alinicia/SolderSync/README.md

# SolderSync PCB Design
Modification of the T-962 reflow owen, ESP32 core with TFT LCD &amp; Custom Profiles
