alinicia/SolderSync/v2.1.0/Schematics/Main/Main_BOOT&EN.png

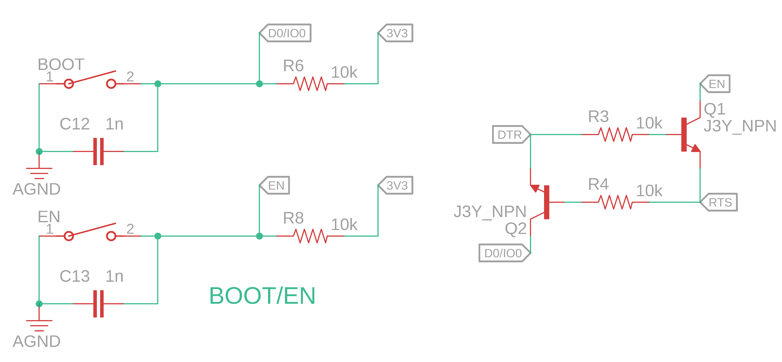
v2.1.0/Schematics/Main/Main_BOOT&EN.png
