alinicia/SolderSync/v2.1.0/Schematics/Main/Main_Connectors.png

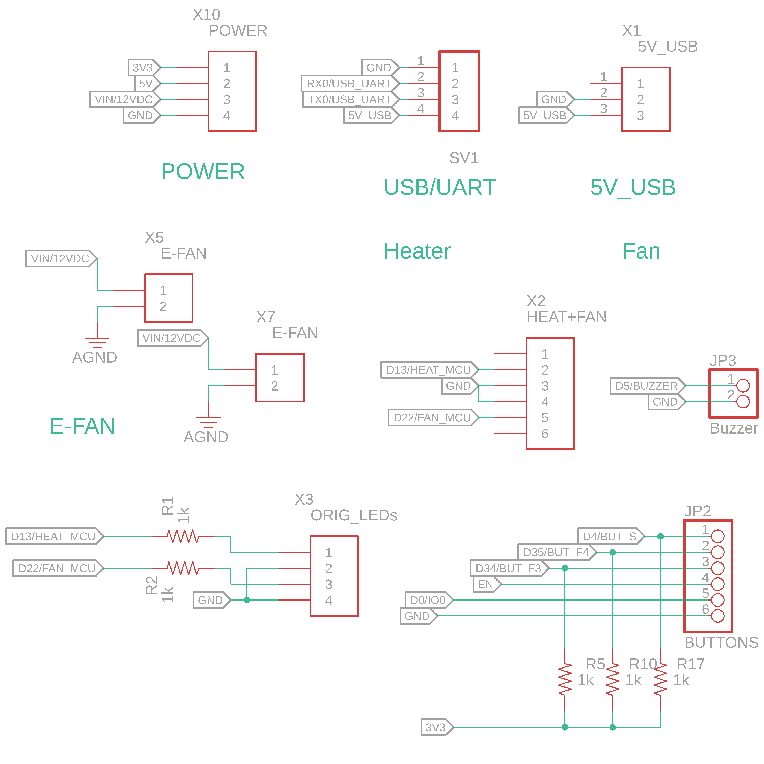
v2.1.0/Schematics/Main/Main_Connectors.png
