alinicia/SolderSync/v2.1.0/Schematics/Main/Main_LCD.png

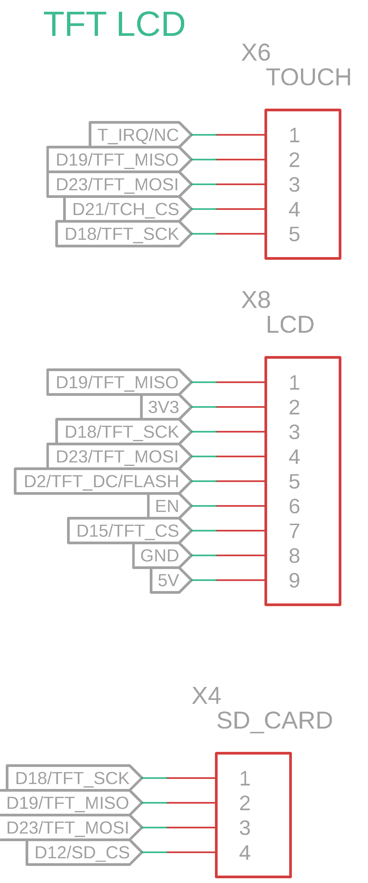
v2.1.0/Schematics/Main/Main_LCD.png
