alinicia/SolderSync/v2.1.0/Schematics/Main/Main_LEDs.png

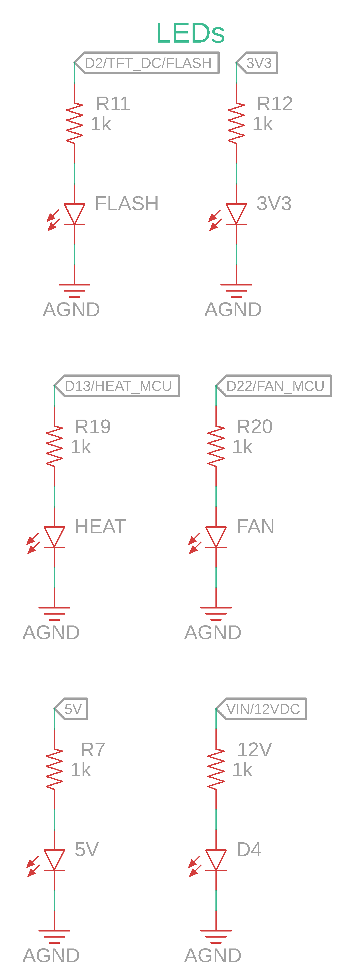
v2.1.0/Schematics/Main/Main_LEDs.png
