alinicia/SolderSync/v2.1.0/Schematics/Main/Main_MCU.png

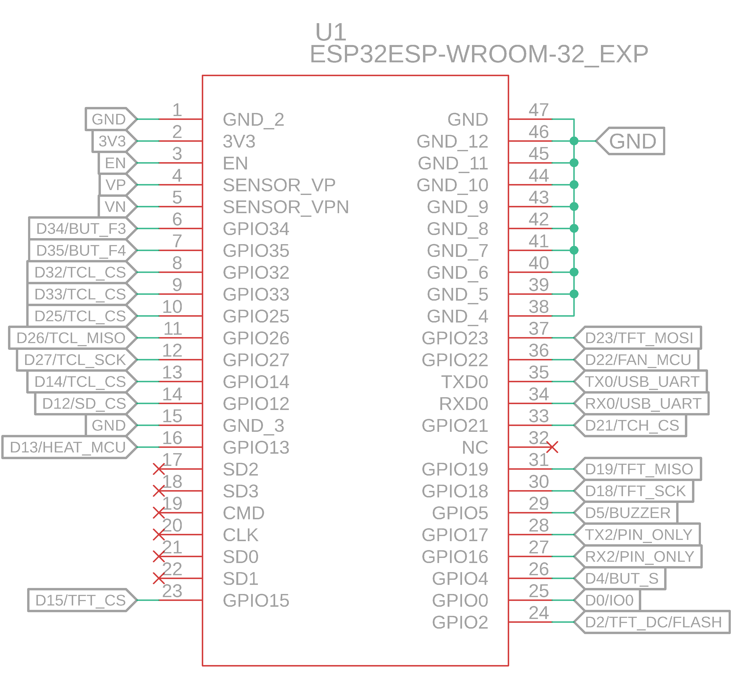
v2.1.0/Schematics/Main/Main_MCU.png
