alinicia/SolderSync/v2.1.0/Schematics/Main/Main_Thermocouples.png

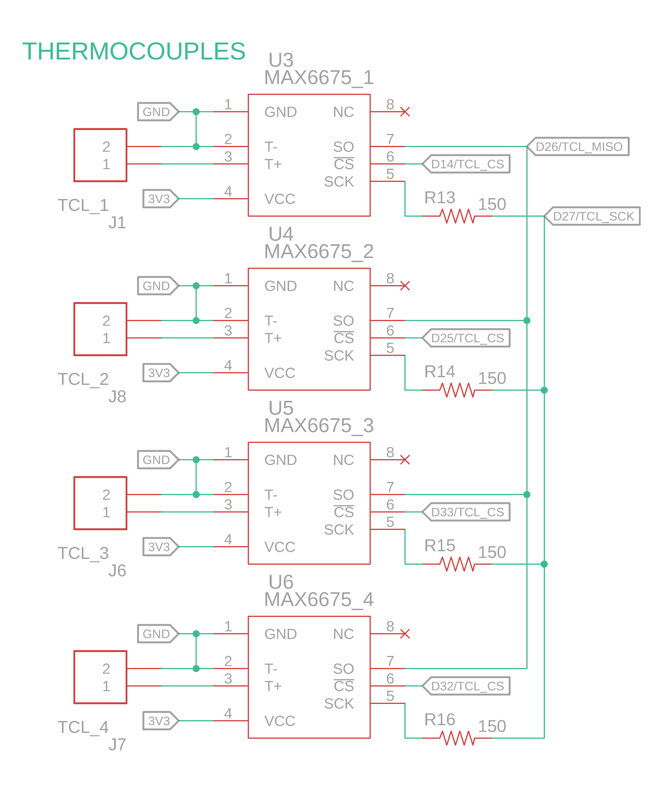
v2.1.0/Schematics/Main/Main_Thermocouples.png
