alinicia/SolderSync/v2.1.0/Schematics/Power/Power_ACDC.png

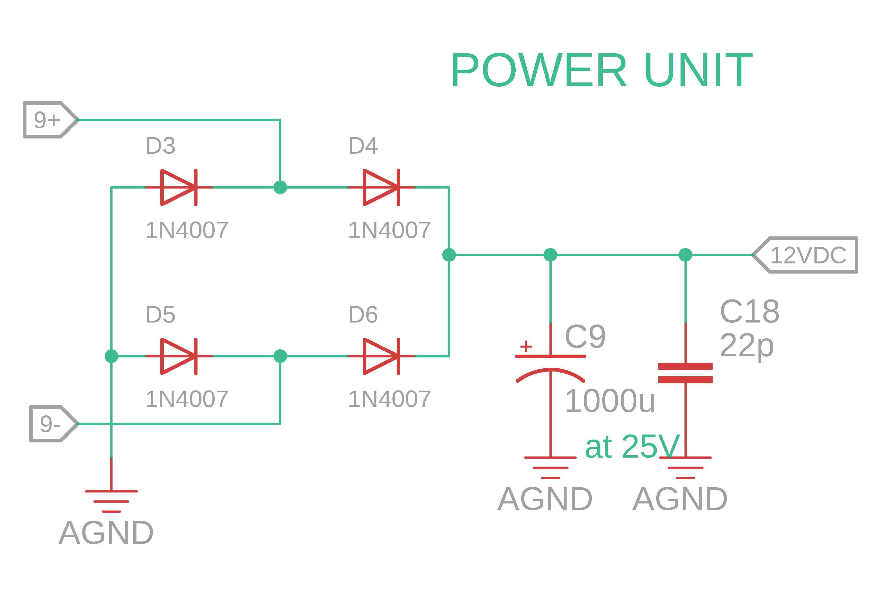
v2.1.0/Schematics/Power/Power_ACDC.png
