alinicia/SolderSync/v2.1.0/Schematics/Power/Power_LEDs&Connectors.png

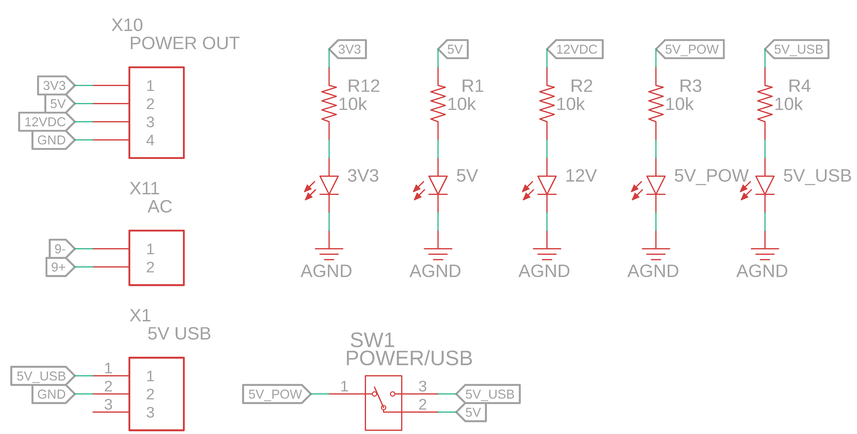
v2.1.0/Schematics/Power/Power_LEDs&Connectors.png
