alinicia/SolderSync/v2.1.0/Schematics/Power/Power_Regulators.png

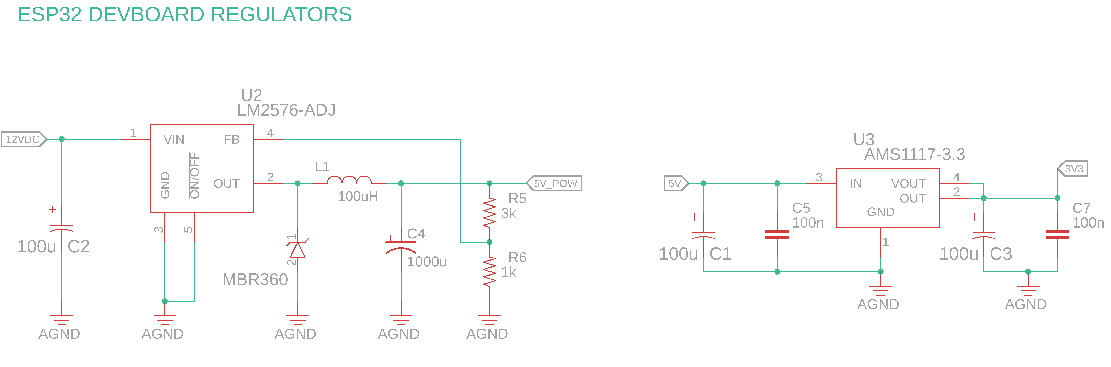
v2.1.0/Schematics/Power/Power_Regulators.png
