alinicia/SolderSync/v2.1.0/v1 USB_UART.brd

## EAGLE design v2.1.0/v1 USB_UART.brd (2025-04-17, an earlier design)

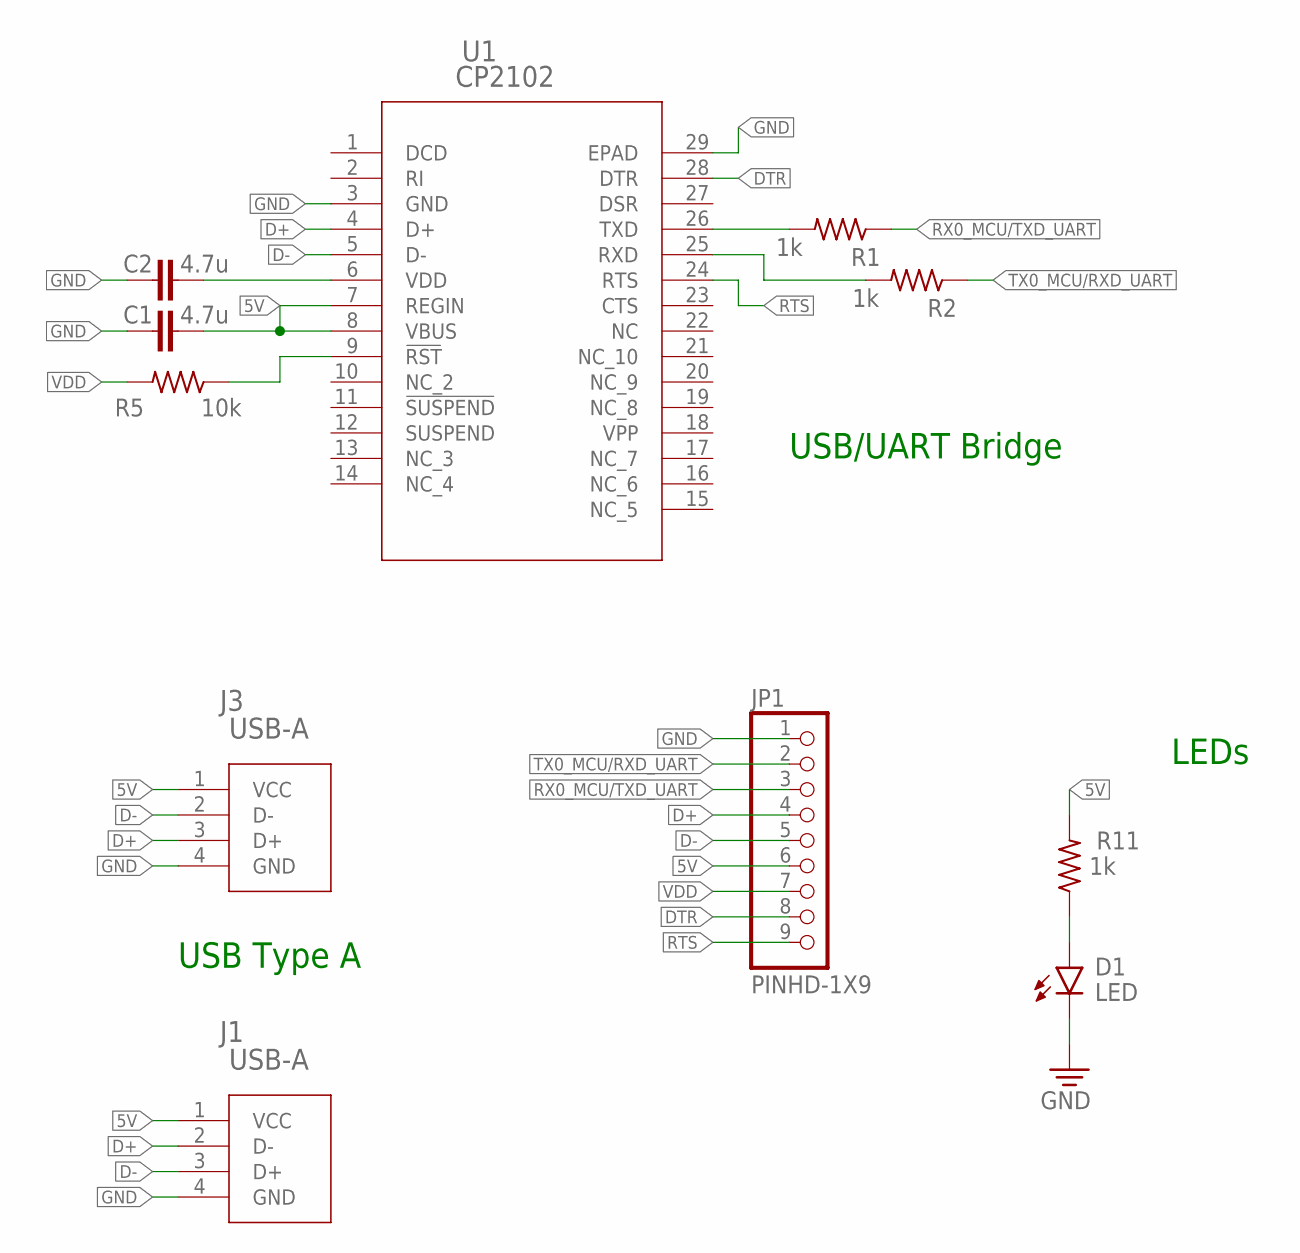
[picture p12: schematic v1 USB_UART.sch]

Parts:
C1, C2: 4.7u; CAPC2012X110
D1: LED; LEDC2012X110N_FLAT-B
J1, J3: USB-A
JP1: PINHD-1X9; 1X09
R1, R2, R11: 1k; RESC2012X65
R5: 10k; RESC2012X65
U1: CP2102; QFN28_5X5_SIL

Connections:
5V: C1.2, J1.1 (VCC), J3.1 (VCC), JP1.6, R11.2, U1.7 (REGIN), U1.8 (VBUS)
D+: J1.2 (D-), J3.3 (D+), JP1.4, U1.4 (D+)
D-: J1.3 (D+), J3.2 (D-), JP1.5, U1.5 (D-)
DTR: JP1.8, U1.28 (DTR)
GND: C1.1, C2.1, D1.C, J1.4 (GND), J3.4 (GND), JP1.1, U1.3 (GND), U1.29 (EPAD)
unnamed: D1.A, R11.1
unnamed: R5.1, U1.9 (!RST)
RTS: JP1.9, U1.24 (RTS)
RX0_MCU/TXD_UART: JP1.3, R1.1
RXD: R2.2, U1.25 (RXD)
TX0_MCU/RXD_UART: JP1.2, R2.1
TXD: R1.2, U1.26 (TXD)
VDD: C2.2, JP1.7, R5.2, U1.6 (VDD)

Notes on the sheet:
USB/UART Bridge
USB Type A
LEDs

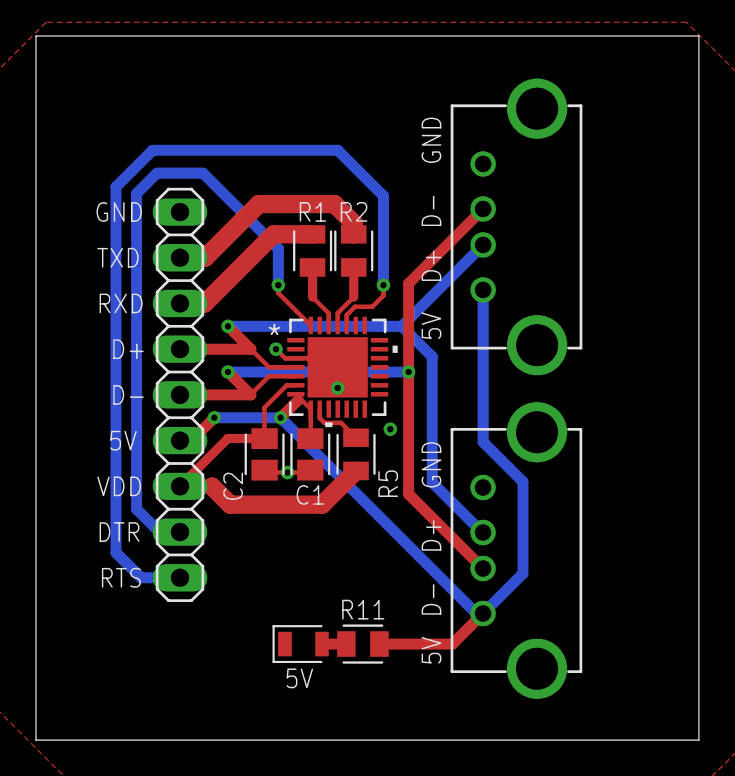
[picture p13: board v1 USB_UART.brd from above]

Board: 2 copper layers, 36.8 x 39.1 mm, 11 parts (0 on the bottom side), 13 nets.
