alinicia/SolderSync/v2.1.0/v2.1 Power.brd

## EAGLE design v2.1.0/v2.1 Power.brd (2025-04-17)

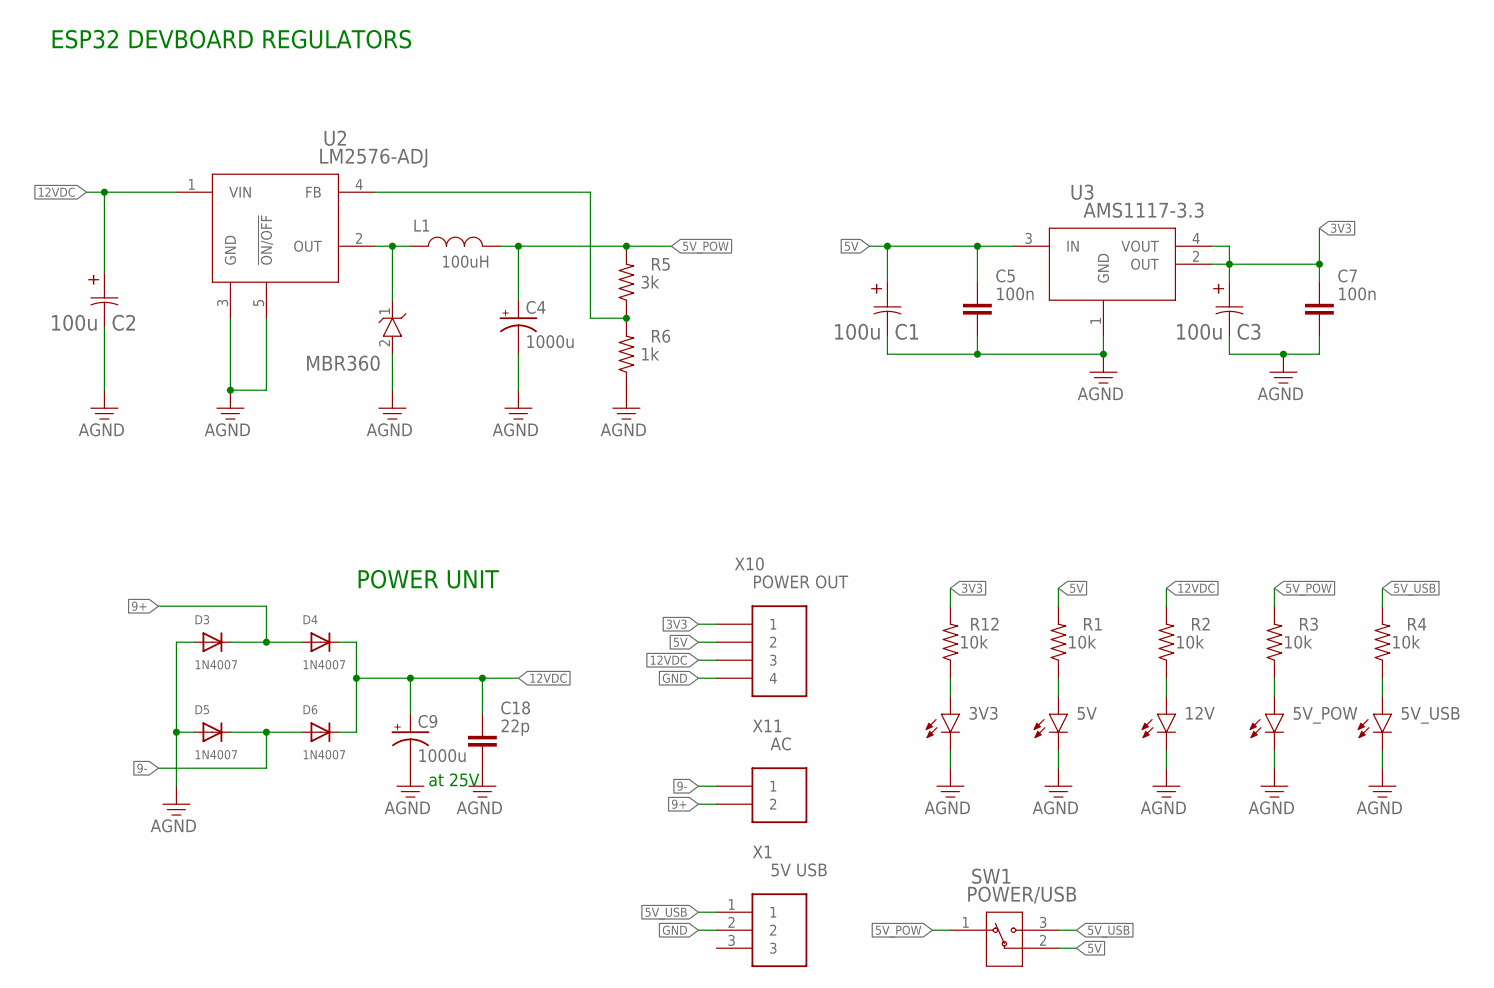
[picture p14: schematic v2.1 Power.sch]

Parts:
3V3, 5V, 5V_POW, 5V_USB, 12V: LED; LEDC2012X110N_FLAT-B
C1, C2, C3: 100u; 100UF_CAP
C4, C9: 1000u; CAP_10X20IN
C5, C7: 100n; CAPC2012X110
C18: 22p; CAPC2012X110
D3, D4, D5, D6: 1N4007; SOD-123FL
L1: 100uH; IND_MURATA_2200_MUR
MBR360: MBR360RLGDO-201AD_ONS; DO-201AD_ONS
R1, R2, R3, R4, R12: 10k; RESC2012X65
R5: 3k; RESC2012X65
R6: 1k; RESC2012X65
SW1: POWER/USB; SS-12D10G5_XKB
U2: LM2576-ADJ; T05A_TEX
U3: AMS1117-3.3; _ADS-L
X1: 5V USB; JST-XH-03-PACKAGE-LONG-PAD
X10: POWER OUT; JST-XH-04-PACKAGE-LONG-PAD
X11: AC; -LONG-PAD

Connections:
3V3: C3.1, C7.1, R12.2, U3.2 (OUT), U3.4 (VOUT), X10.1
5V: C1.1, C5.1, R1.2, SW1.2, U3.3 (IN), X10.2
5V_POW: C4.1 (+), L1.1, R3.2, R5.2, SW1.1
5V_USB: R4.2, SW1.3, X1.1
9+: D3.C, D4.A, X11.2
9-: D5.C, D6.A, X11.1
12VDC: C2.1, C9.1 (+), C18.1, D4.C, D6.C, R2.2, U2.1 (VIN), X10.3
FB: R5.1, R6.2, U2.4 (FB)
GND: 3V3.C, 5V.C, 5V_POW.C, 5V_USB.C, 12V.C, C1.2, C2.2, C3.2, C4.2 (-), C5.2, C7.2, C9.2 (-), C18.2, D3.A, D5.A, MBR360.2 (ANODE), R6.1, U2.3 (GND), U2.5 (!ON/OFF), U3.1 (GND), X1.2, X10.4
unnamed: 5V.A, R1.1
unnamed: L1.2, MBR360.1 (CATHODE), U2.2 (OUT)
unnamed: 12V.A, R2.1
unnamed: 5V_POW.A, R3.1
unnamed: 5V_USB.A, R4.1
unnamed: 3V3.A, R12.1

Notes on the sheet:
ESP32 DEVBOARD REGULATORS
POWER UNIT
at 25V

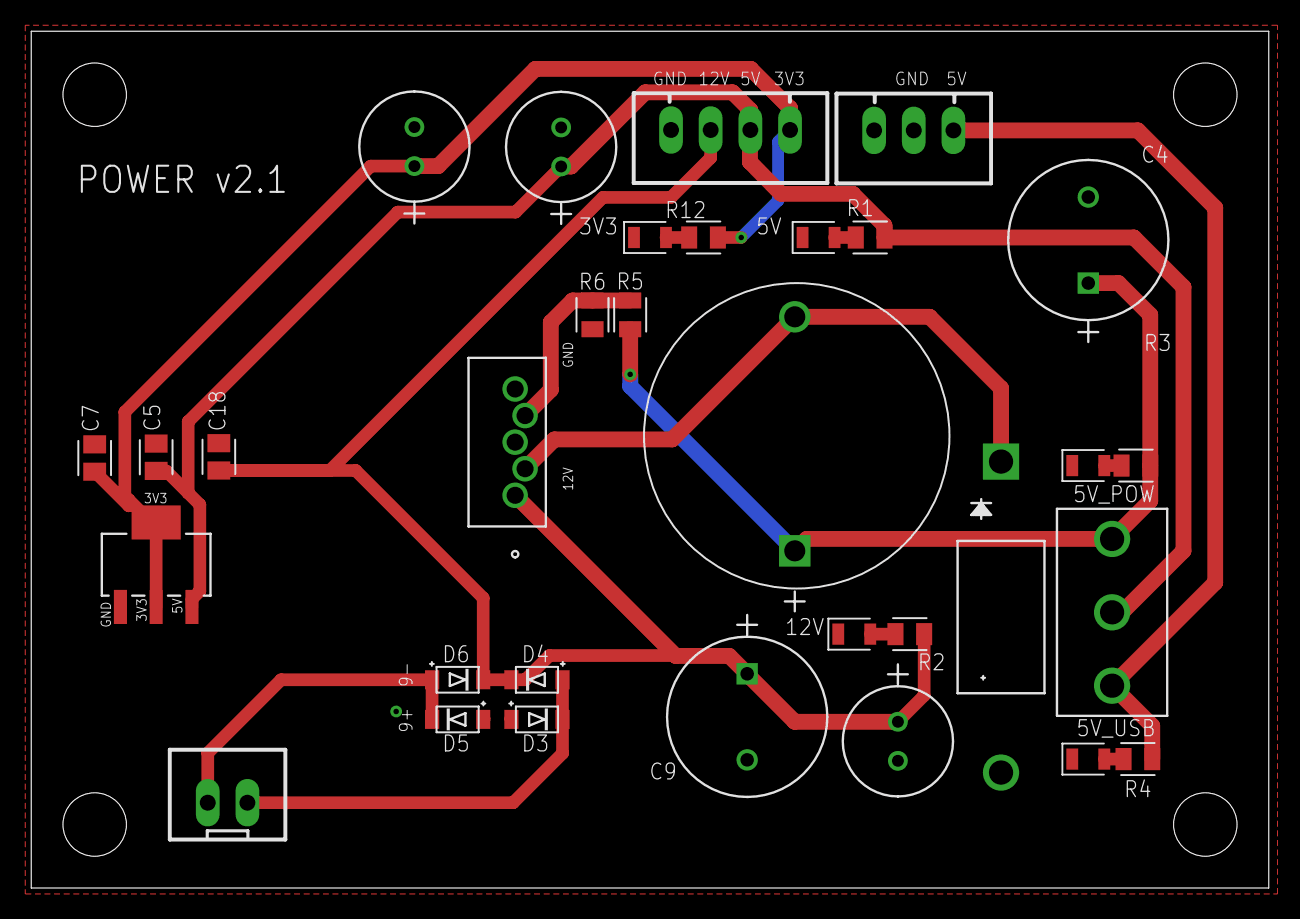
[picture p15: board v2.1 Power.brd from above]

Board: 2 copper layers, 79.2 x 54.9 mm, 32 parts (0 on the bottom side), 15 nets.
