alinicia/SolderSync/v2.1.0/v2.1 Main.brd

## EAGLE design v2.1.0/v2.1 Main.brd (2025-04-17)

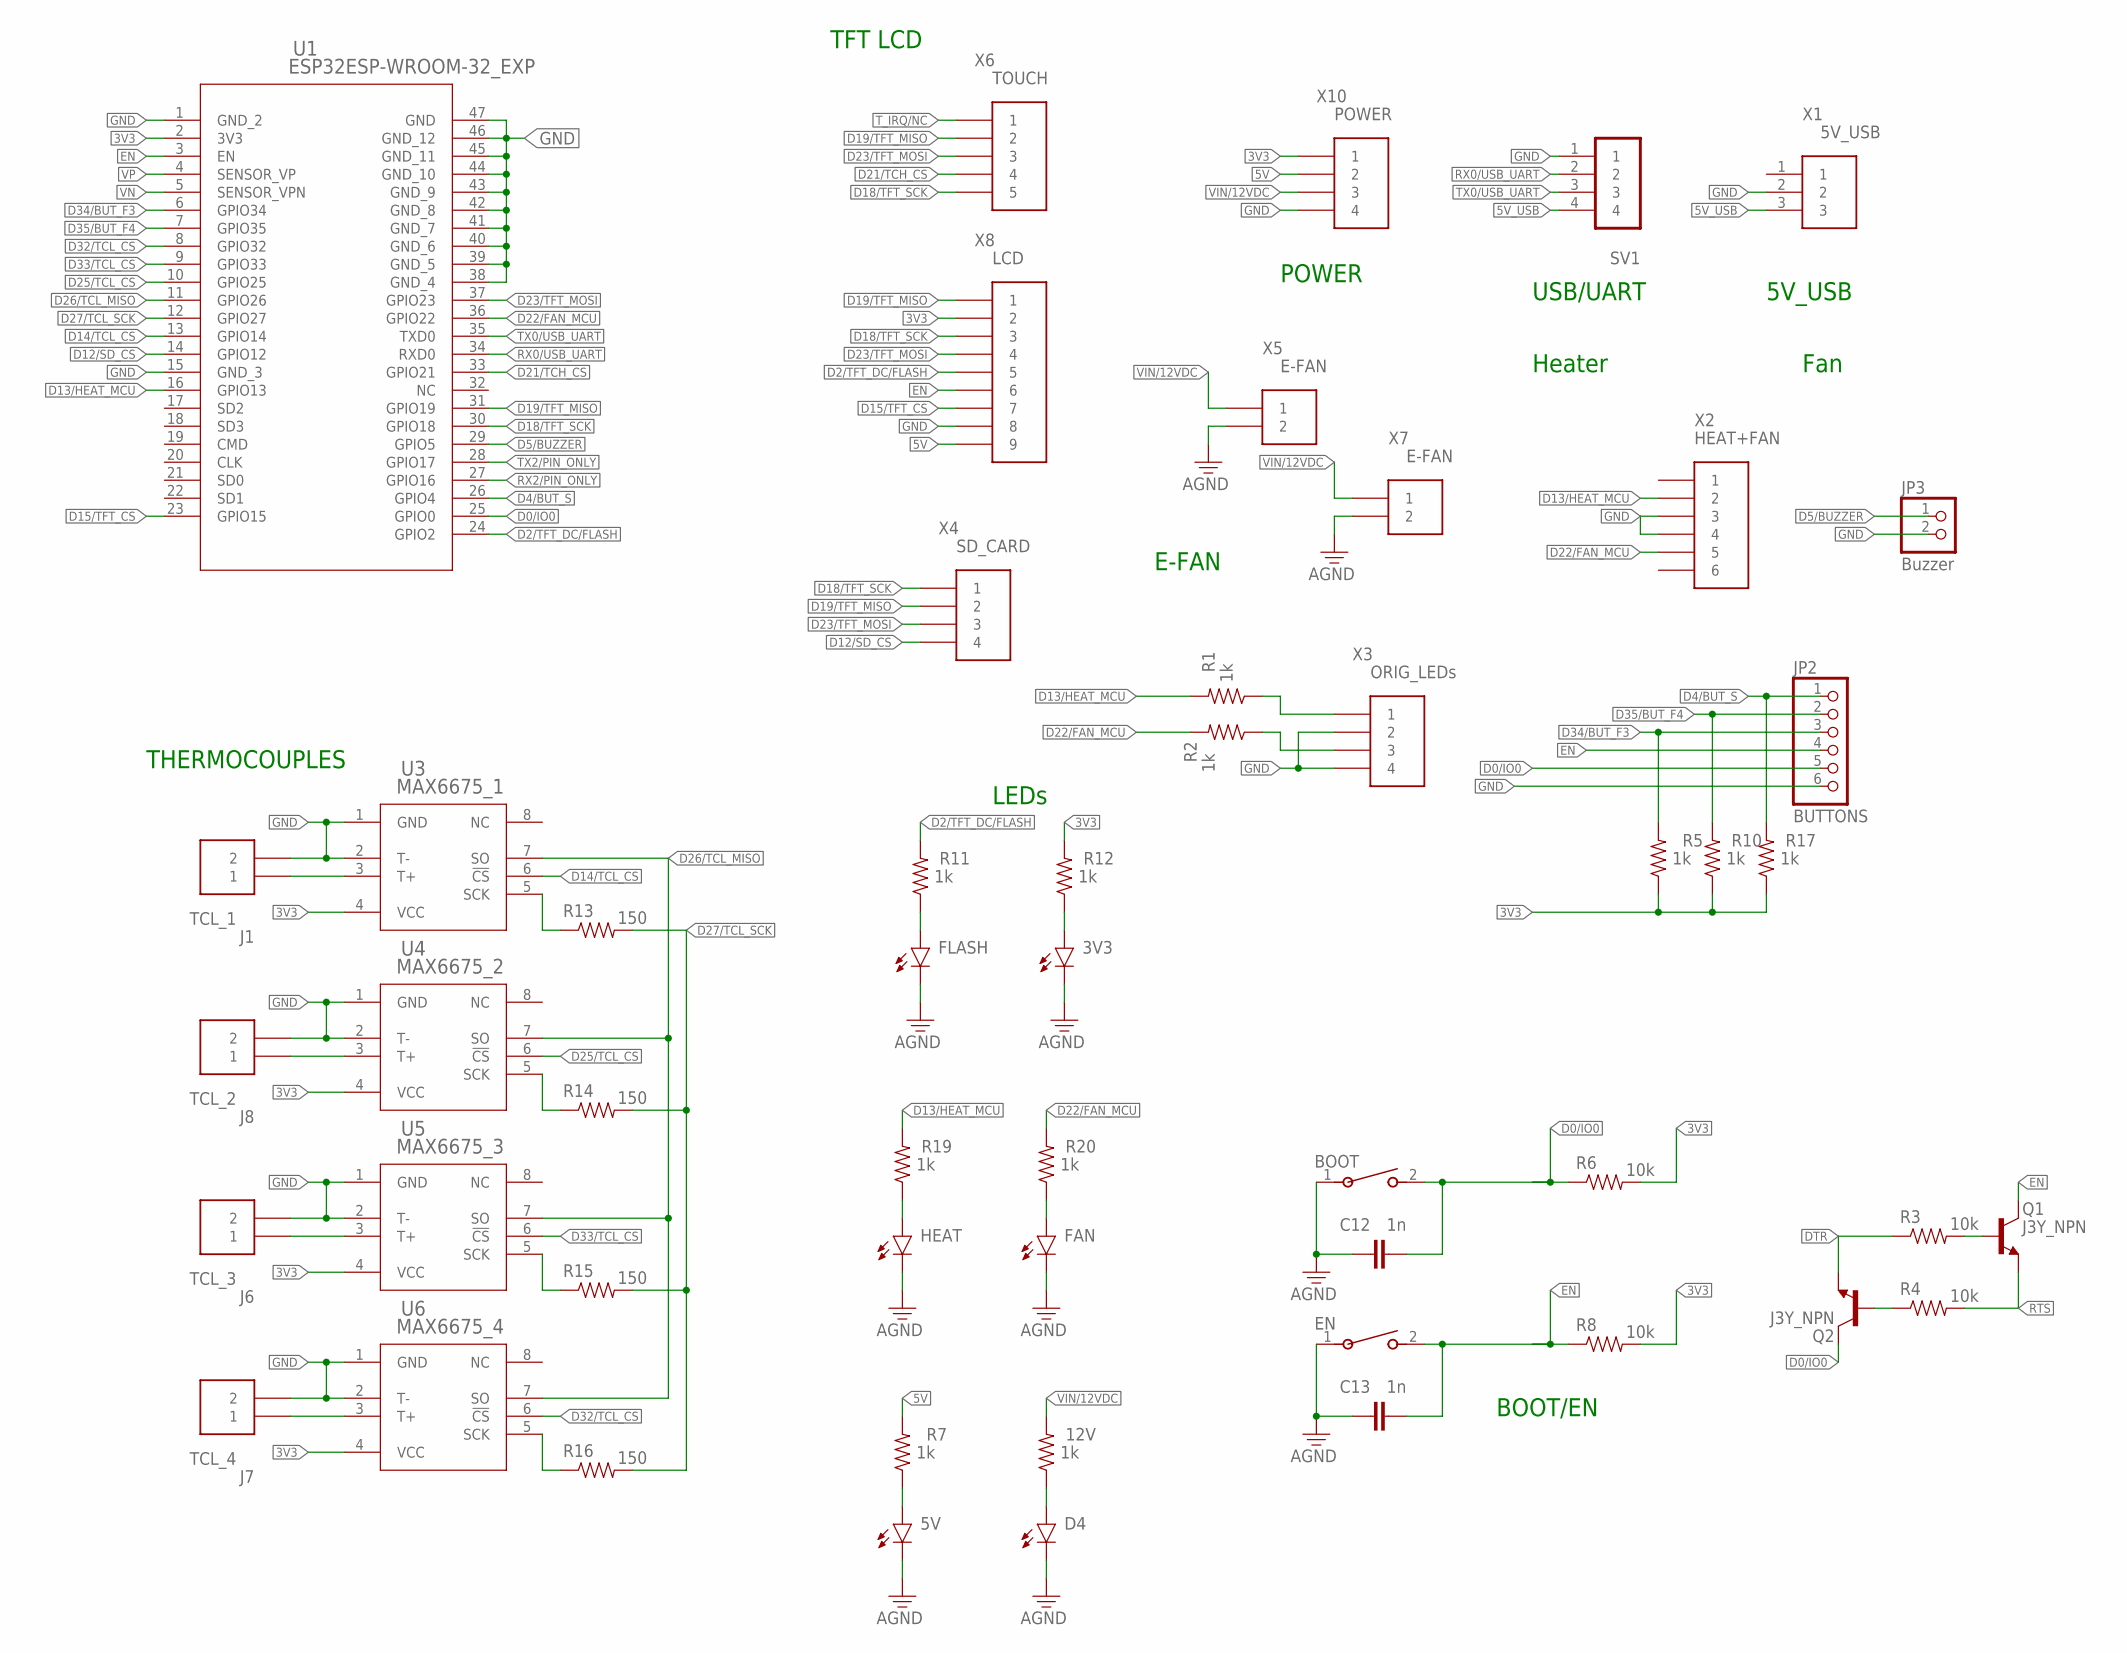
[picture p16: schematic v2.1 Main.sch]

Parts:
3V3, 5V: LED; LEDC2012X110N_FLAT-B
12V: 1k; RESC2012X65
BOOT: EVQ22705RSW_EVQ22705R_PAN; SW_EVQ22705R_PAN
C12, C13: 1n; CAPC2012X110
D4: LED; LEDC2012X110N_FLAT-B
EN: EVQ22705RSW_EVQ22705R_PAN; SW_EVQ22705R_PAN
FAN: LED; LEDC2012X110N_FLAT-B
FLASH: LED; LEDC2012X110N_FLAT-B
HEAT: LED; LEDC2012X110N_FLAT-B
J1: TCL_1; CONN_OSTVN02A150_OST
J6: TCL_3; CONN_OSTVN02A150_OST
J7: TCL_4; CONN_OSTVN02A150_OST
J8: TCL_2; CONN_OSTVN02A150_OST
JP2: BUTTONS; 1X06
JP3: Buzzer; 1X02
Q1, Q2: J3Y_NPN; SC59
R1, R2, R5, R7, R10, R11, R12, R17, R19, R20: 1k; RESC2012X65
R3, R4, R6, R8: 10k; RESC2012X65
R13, R14, R15, R16: 150; RESC2012X65
SV1: FEM-HEAD; FE05-1
U1: ESP32ESP-WROOM-32_EXP; ESP32_SCH_PCB
U3: MAX6675_1; 21-0041B_8_MXM
U4: MAX6675_2; 21-0041B_8_MXM
U5: MAX6675_3; 21-0041B_8_MXM
U6: MAX6675_4; 21-0041B_8_MXM
X1: 5V_USB; JST-XH-03-PACKAGE-LONG-PAD
X2: HEAT+FAN; JST-XH-06-PACKAGE-LONG-PAD
X3: ORIG_LEDs; JST-XH-04-PACKAGE-LONG-PAD
X4: SD_CARD; JST-XH-04-PACKAGE-LONG-PAD
X5, X7: E-FAN; -LONG-PAD
X6: TOUCH; JST-XH-05-PACKAGE-LONG-PAD
X8: LCD; JST-XH-09-PACKAGE-LONG-PAD
X10: POWER; JST-XH-04-PACKAGE-LONG-PAD

Connections:
3V3: R5.1, R6.2, R8.2, R10.1, R12.2, R17.1, U1.2 (3V3), U3.4 (VCC), U4.4 (VCC), U5.4 (VCC), U6.4 (VCC), X8.2, X10.1
5V: R7.2, X8.9, X10.2
5V_USB: SV1.4, X1.3
D0/IO0: BOOT.2, C12.2, JP2.5, Q2.C, R6.1, U1.25 (GPIO0)
D2/TFT_DC/FLASH: R11.2, U1.24 (GPIO2), X8.5
D4/BUT_S: JP2.1, R17.2, U1.26 (GPIO4)
D5/BUZZER: JP3.1, U1.29 (GPIO5)
D12/SD_CS: U1.14 (GPIO12), X4.4
D13/HEAT_MCU: R1.2, R19.2, U1.16 (GPIO13), X2.2
D14/TCL_CS: U1.13 (GPIO14), U3.6 (!CS)
D15/TFT_CS: U1.23 (GPIO15), X8.7
D18/TFT_SCK: U1.30 (GPIO18), X4.1, X6.5, X8.3
D19/TFT_MISO: U1.31 (GPIO19), X4.2, X6.2, X8.1
D21/TCH_CS: U1.33 (GPIO21), X6.4
D22/FAN_MCU: R2.2, R20.2, U1.36 (GPIO22), X2.5
D23/TFT_MOSI: U1.37 (GPIO23), X4.3, X6.3, X8.4
D25/TCL_CS: U1.10 (GPIO25), U4.6 (!CS)
D26/TCL_MISO: U1.11 (GPIO26), U3.7 (SO), U4.7 (SO), U5.7 (SO), U6.7 (SO)
D27/TCL_SCK: R13.2, R14.2, R15.2, R16.2, U1.12 (GPIO27)
D32/TCL_CS: U1.8 (GPIO32), U6.6 (!CS)
D33/TCL_CS: U1.9 (GPIO33), U5.6 (!CS)
D34/BUT_F3: JP2.3, R5.2, U1.6 (GPIO34)
D35/BUT_F4: JP2.2, R10.2, U1.7 (GPIO35)
DTR: Q2.E, R3.1
EN: C13.2, EN.2, JP2.4, Q1.C, R8.1, U1.3 (EN), X8.6
FAN_LED: R2.1, X3.3
GND: 3V3.C, 5V.C, BOOT.1, C12.1, C13.1, D4.C, EN.1, FAN.C, FLASH.C, HEAT.C, J1.2, J6.2, J7.2, J8.2, JP2.6, JP3.2, SV1.1, U1.1 (GND_2), U1.15 (GND_3), U1.38 (GND_4), U1.39 (GND_5), U1.40 (GND_6), U1.41 (GND_7), U1.42 (GND_8), U1.43 (GND_9), U1.44 (GND_10), U1.45 (GND_11), U1.46 (GND_12), U1.47 (GND), U3.1 (GND), U3.2 (T-), U4.1 (GND), U4.2 (T-), U5.1 (GND), U5.2 (T-), U6.1 (GND), U6.2 (T-), X1.2, X2.3, X2.4, X3.2, X3.4, X5.2, X7.2, X8.8, X10.4
HEAT_LED: R1.1, X3.1
unnamed: FLASH.A, R11.1
unnamed: Q1.B, R3.2
unnamed: Q2.B, R4.1
unnamed: 3V3.A, R12.1
unnamed: 5V.A, R7.1
unnamed: 12V.1, D4.A
unnamed: HEAT.A, R19.1
unnamed: FAN.A, R20.1
RTS: Q1.E, R4.2
RX0/USB_UART: SV1.2, U1.34 (RXD0)
RX2/PIN_ONLY: U1.27 (GPIO16)
T1: J1.1, U3.3 (T+)
T2: J8.1, U4.3 (T+)
T3: J6.1, U5.3 (T+)
T4: J7.1, U6.3 (T+)
TCL_SCK1: R13.1, U3.5 (SCK)
TCL_SCK2: R14.1, U4.5 (SCK)
TCL_SCK3: R15.1, U5.5 (SCK)
TCL_SCK4: R16.1, U6.5 (SCK)
TX0/USB_UART: SV1.3, U1.35 (TXD0)
TX2/PIN_ONLY: U1.28 (GPIO17)
T_IRQ/NC: X6.1
VIN/12VDC: 12V.2, X5.1, X7.1, X10.3
VN: U1.5 (SENSOR_VPN)
VP: U1.4 (SENSOR_VP)

Notes on the sheet:
TFT LCD
BOOT/EN
LEDs
THERMOCOUPLES
E-FAN
POWER
Heater
Fan
USB/UART
5V_USB

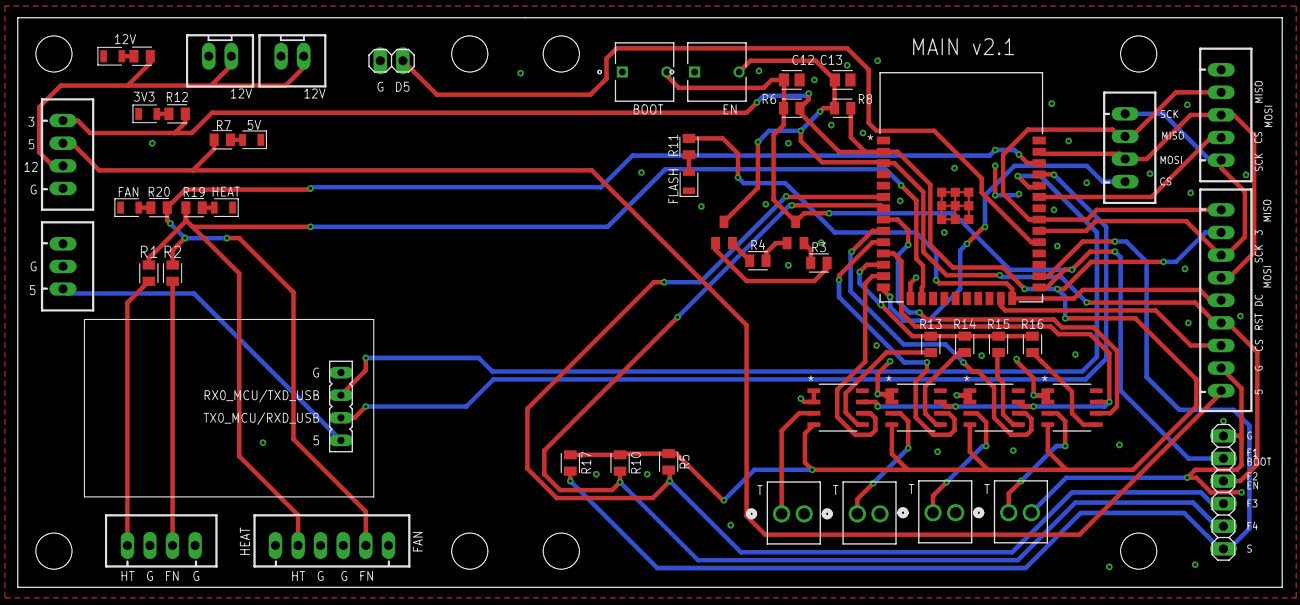
[picture p17: board v2.1 Main.brd from above]

Board: 2 copper layers, 142.1 x 64.0 mm, 52 parts (0 on the bottom side), 48 nets.
