alinicia/SolderSync/v1.1.0/v1.1 Main.brd

## EAGLE design v1.1.0/v1.1 Main.brd (2025-03-05, an earlier design)

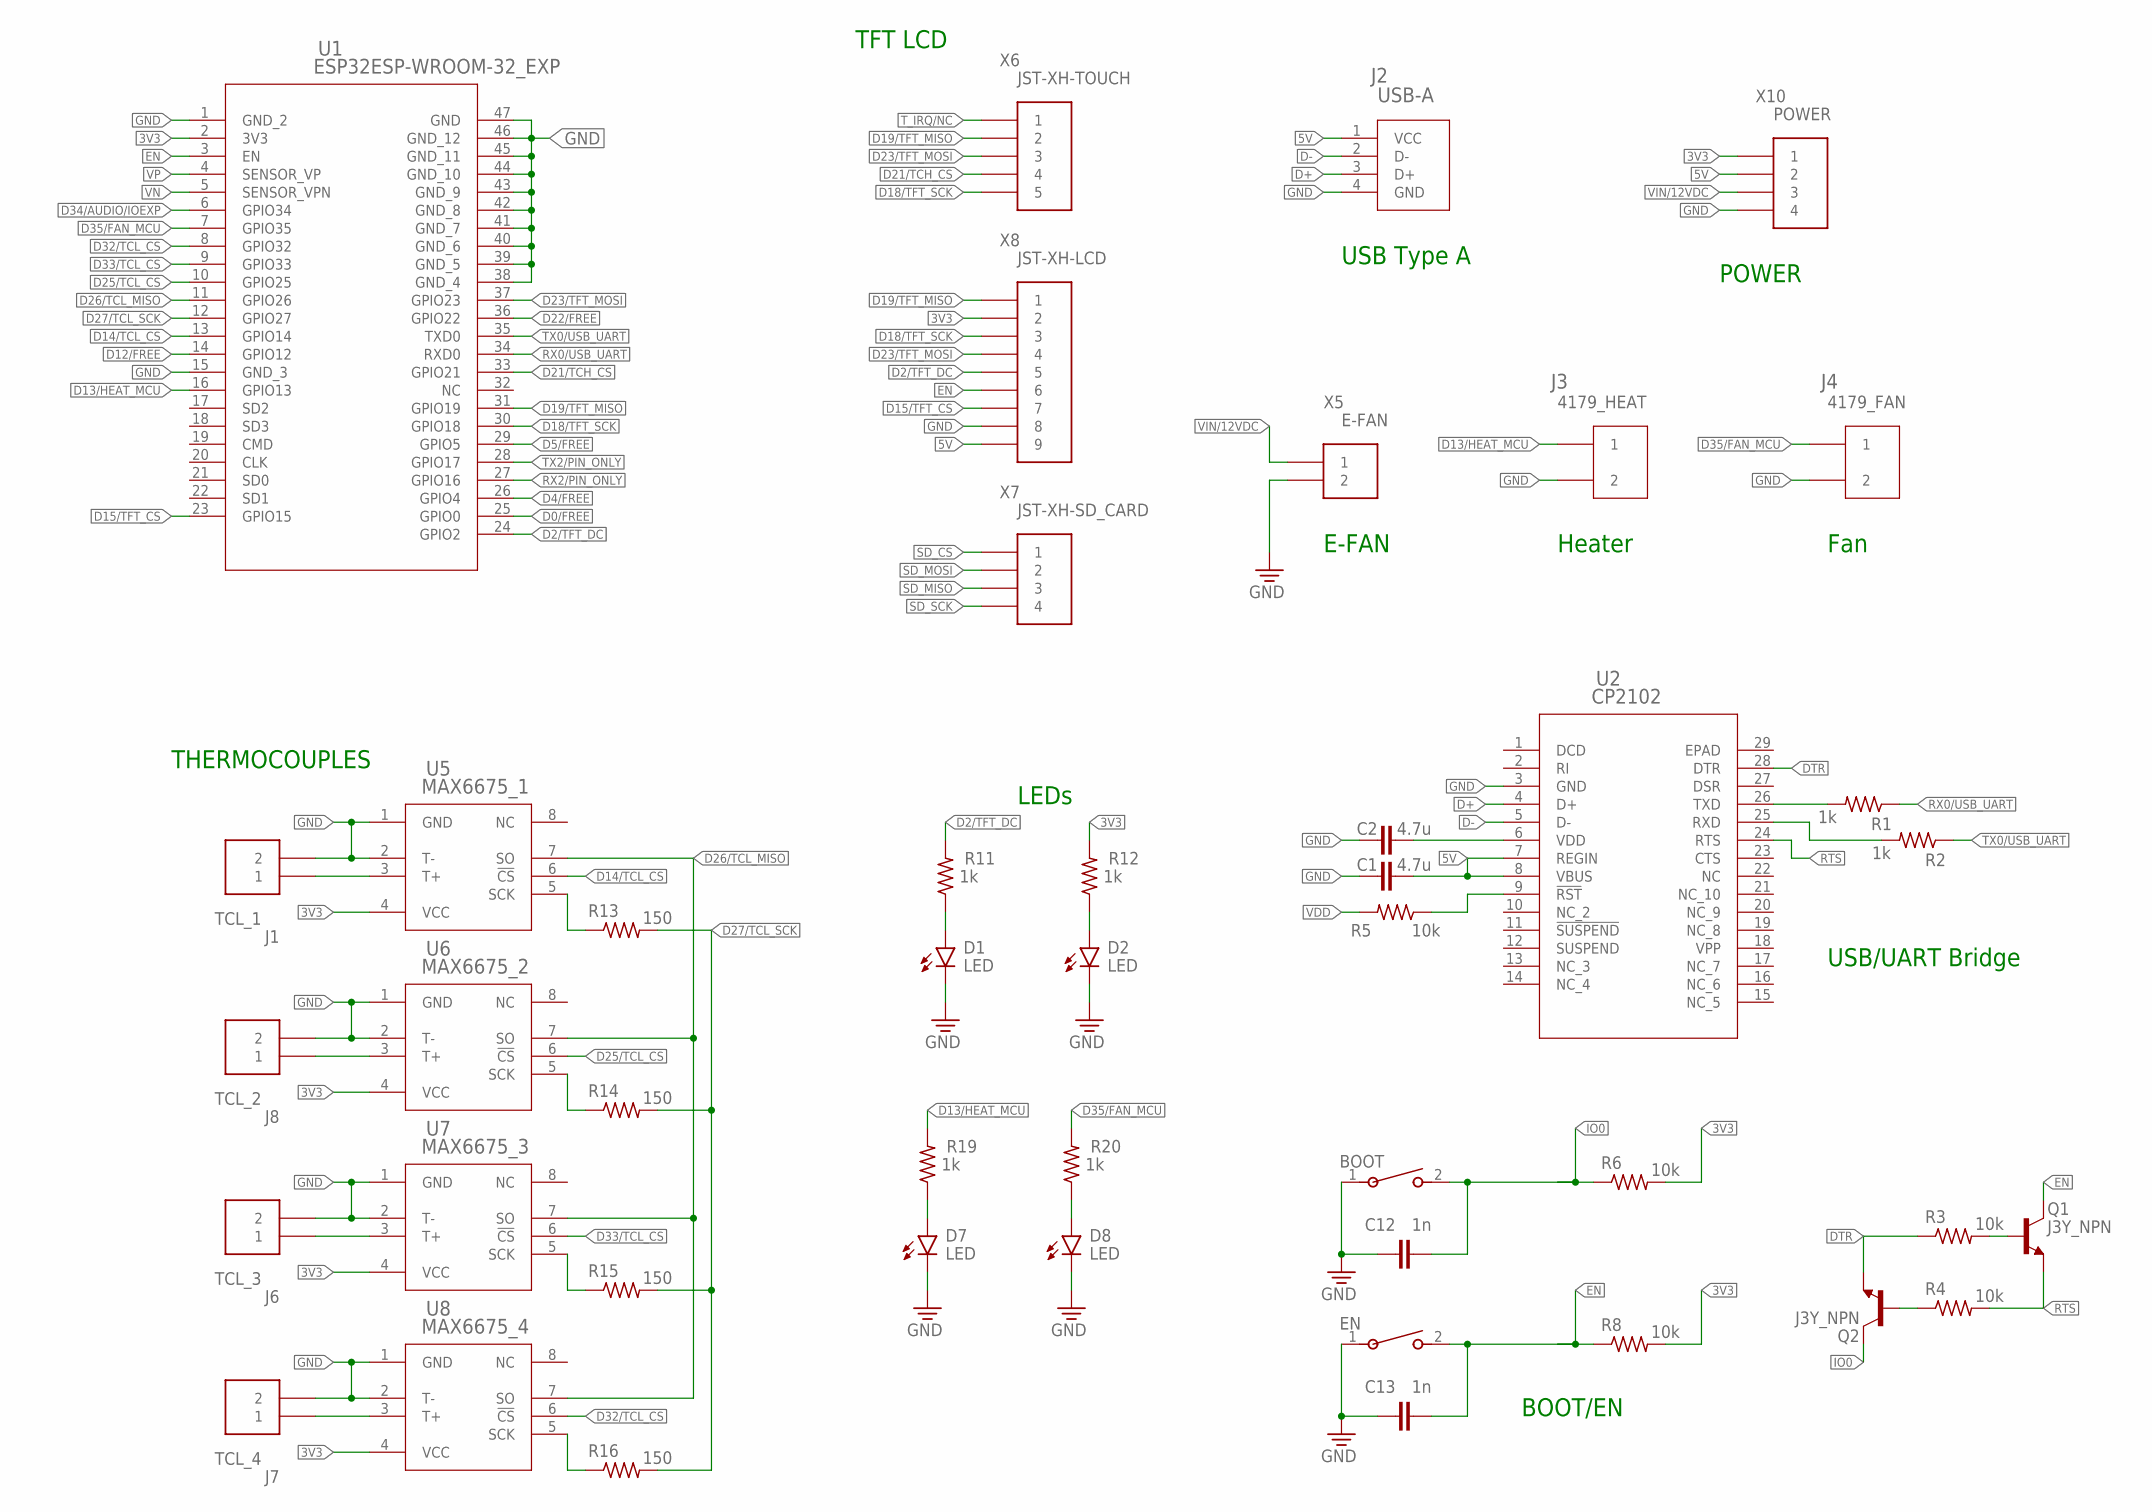
[picture p18: schematic v1.1 Main.sch]

Parts:
BOOT: EVQ22705RSW_EVQ22705R_PAN; SW_EVQ22705R_PAN
C1, C2: 4.7u; CAPC2012X110
C12, C13: 1n; CAPC2012X110
D1, D2, D7, D8: LED; LEDC2012X110N_FLAT-B
EN: EVQ22705RSW_EVQ22705R_PAN; SW_EVQ22705R_PAN
J1: TCL_1; CONN_OSTVN02A150_OST
J2: USB-A
J3: 4179_HEAT; 41791
J4: 4179_FAN; 41791
J6: TCL_3; CONN_OSTVN02A150_OST
J7: TCL_4; CONN_OSTVN02A150_OST
J8: TCL_2; CONN_OSTVN02A150_OST
Q1, Q2: J3Y_NPN; SC59
R1, R2, R11, R12, R19, R20: 1k; RESC2012X65
R3, R4, R5, R6, R8: 10k; RESC2012X65
R13, R14, R15, R16: 150; RESC2012X65
U1: ESP32ESP-WROOM-32_EXP; ESP32_SCH_PCB
U2: CP2102; QFN28_5X5_SIL
U5: MAX6675_1; _ISA_MXM
U6: MAX6675_2; _ISA_MXM
U7: MAX6675_3; _ISA_MXM
U8: MAX6675_4; _ISA_MXM
X5: E-FAN; -LONG-PAD
X6: JST-XH-TOUCH; JST-XH-05-PACKAGE-LONG-PAD
X7: JST-XH-SD_CARD; JST-XH-04-PACKAGE-LONG-PAD
X8: JST-XH-LCD; JST-XH-09-PACKAGE-LONG-PAD
X10: POWER; JST-XH-04-PACKAGE-LONG-PAD

Connections:
3V3: R6.2, R8.2, R12.2, U1.2 (3V3), U5.4 (VCC), U6.4 (VCC), U7.4 (VCC), U8.4 (VCC), X8.2, X10.1
5V: C1.2, J2.1 (VCC), U2.7 (REGIN), U2.8 (VBUS), X8.9, X10.2
D0/FREE: U1.25 (GPIO0)
D2/TFT_DC: R11.2, U1.24 (GPIO2), X8.5
D4/FREE: U1.26 (GPIO4)
D5/FREE: U1.29 (GPIO5)
D12/FREE: U1.14 (GPIO12)
D13/HEAT_MCU: J3.1, R19.2, U1.16 (GPIO13)
D14/TCL_CS: U1.13 (GPIO14), U5.6 (!CS)
D15/TFT_CS: U1.23 (GPIO15), X8.7
D18/TFT_SCK: U1.30 (GPIO18), X6.5, X8.3
D19/TFT_MISO: U1.31 (GPIO19), X6.2, X8.1
D21/TCH_CS: U1.33 (GPIO21), X6.4
D22/FREE: U1.36 (GPIO22)
D23/TFT_MOSI: U1.37 (GPIO23), X6.3, X8.4
D25/TCL_CS: U1.10 (GPIO25), U6.6 (!CS)
D26/TCL_MISO: U1.11 (GPIO26), U5.7 (SO), U6.7 (SO), U7.7 (SO), U8.7 (SO)
D27/TCL_SCK: R13.2, R14.2, R15.2, R16.2, U1.12 (GPIO27)
D32/TCL_CS: U1.8 (GPIO32), U8.6 (!CS)
D33/TCL_CS: U1.9 (GPIO33), U7.6 (!CS)
D34/AUDIO/IOEXP: U1.6 (GPIO34)
D35/FAN_MCU: J4.1, R20.2, U1.7 (GPIO35)
D+: J2.3 (D+), U2.4 (D+)
D-: J2.2 (D-), U2.5 (D-)
DTR: Q2.E, R3.1, U2.28 (DTR)
EN: C13.2, EN.2, Q1.C, R8.1, U1.3 (EN), X8.6
GND: BOOT.1, C1.1, C2.1, C12.1, C13.1, D1.C, D2.C, D7.C, D8.C, EN.1, J1.2, J2.4 (GND), J3.2, J4.2, J6.2, J7.2, J8.2, U1.1 (GND_2), U1.15 (GND_3), U1.38 (GND_4), U1.39 (GND_5), U1.40 (GND_6), U1.41 (GND_7), U1.42 (GND_8), U1.43 (GND_9), U1.44 (GND_10), U1.45 (GND_11), U1.46 (GND_12), U1.47 (GND), U2.3 (GND), U5.1 (GND), U5.2 (T-), U6.1 (GND), U6.2 (T-), U7.1 (GND), U7.2 (T-), U8.1 (GND), U8.2 (T-), X5.2, X8.8, X10.4
IO0: BOOT.2, C12.2, Q2.C, R6.1
unnamed: D1.A, R11.1
unnamed: Q1.B, R3.2
unnamed: R1.2, U2.26 (TXD)
unnamed: Q2.B, R4.1
unnamed: R5.1, U2.9 (!RST)
unnamed: D2.A, R12.1
unnamed: D7.A, R19.1
unnamed: D8.A, R20.1
RTS: Q1.E, R4.2, U2.24 (RTS)
RX0/USB_UART: R1.1, U1.34 (RXD0)
RX2/PIN_ONLY: U1.27 (GPIO16)
RXD: R2.2, U2.25 (RXD)
SD_CS: X7.1
SD_MISO: X7.3
SD_MOSI: X7.2
SD_SCK: X7.4
T1: J1.1, U5.3 (T+)
T2: J8.1, U6.3 (T+)
T3: J6.1, U7.3 (T+)
T4: J7.1, U8.3 (T+)
TCL_SCK1: R13.1, U5.5 (SCK)
TCL_SCK2: R14.1, U6.5 (SCK)
TCL_SCK3: R15.1, U7.5 (SCK)
TCL_SCK4: R16.1, U8.5 (SCK)
TX0/USB_UART: R2.1, U1.35 (TXD0)
TX2/PIN_ONLY: U1.28 (GPIO17)
T_IRQ/NC: X6.1
VDD: C2.2, R5.2, U2.6 (VDD)
VIN/12VDC: X5.1, X10.3
VN: U1.5 (SENSOR_VPN)
VP: U1.4 (SENSOR_VP)

Notes on the sheet:
TFT LCD
USB Type A
USB/UART Bridge
BOOT/EN
LEDs
THERMOCOUPLES
E-FAN
POWER
Heater
Fan

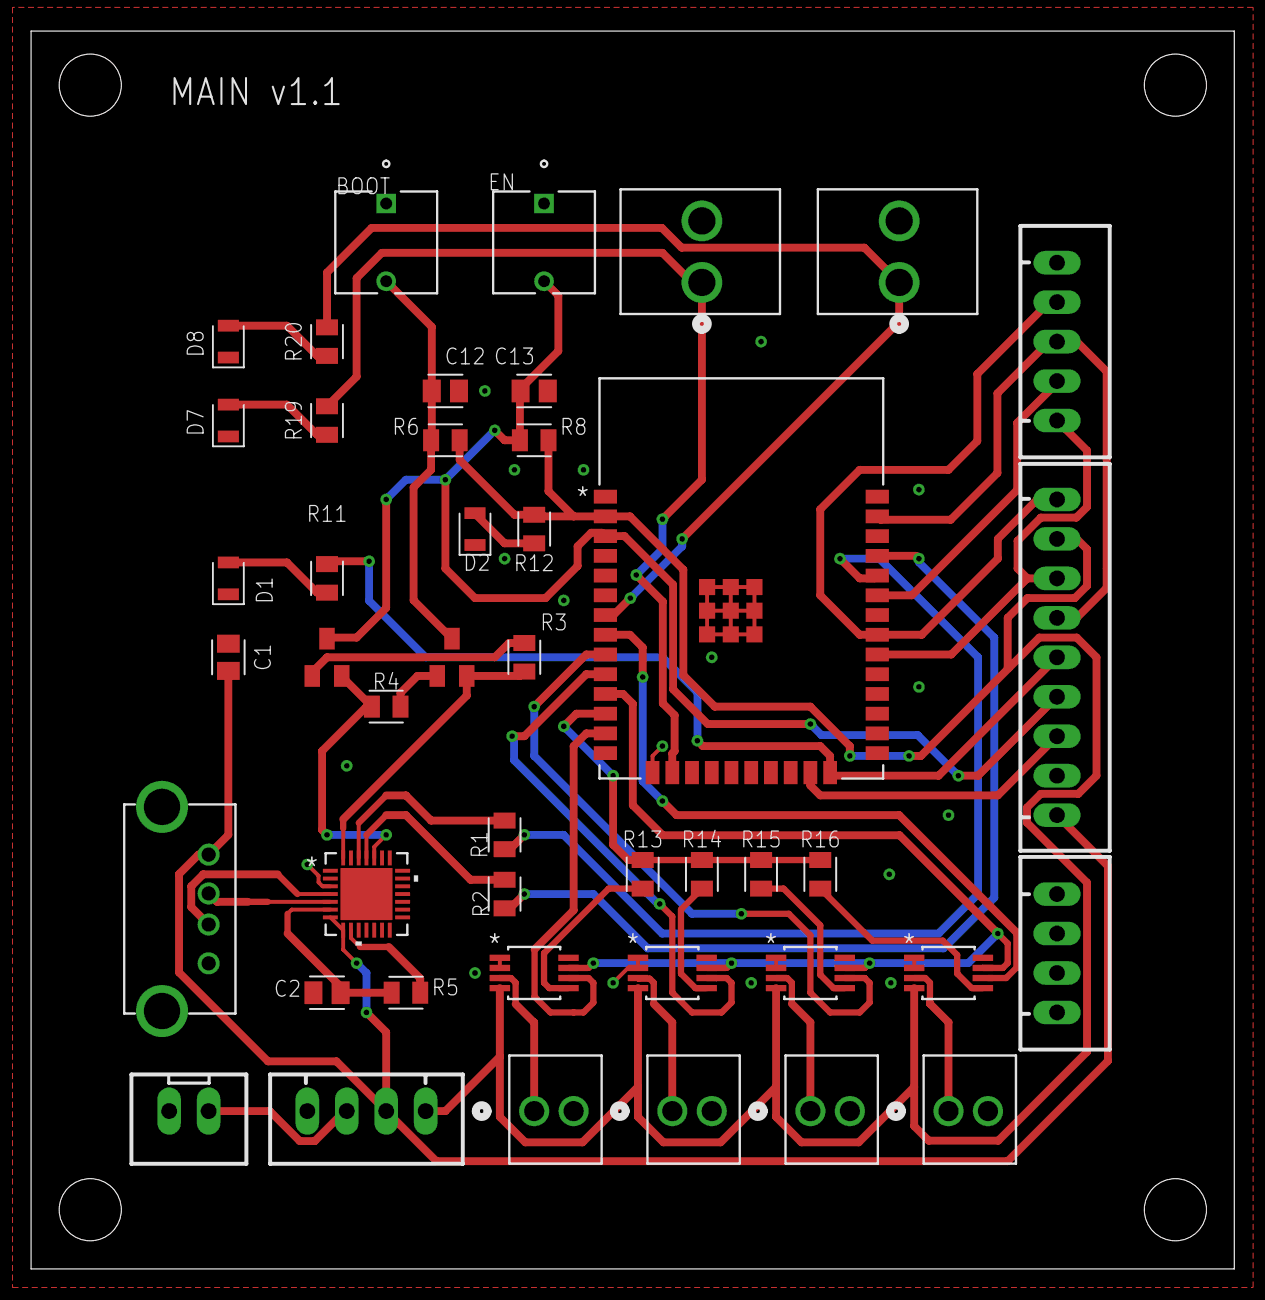
[picture p19: board v1.1 Main.brd from above]

Board: 2 copper layers, 77.5 x 79.7 mm, 45 parts (0 on the bottom side), 44 nets.
