alinicia/SolderSync/v1.1.0/v1.1 Power.brd

## EAGLE design v1.1.0/v1.1 Power.brd (2025-03-05, an earlier design)

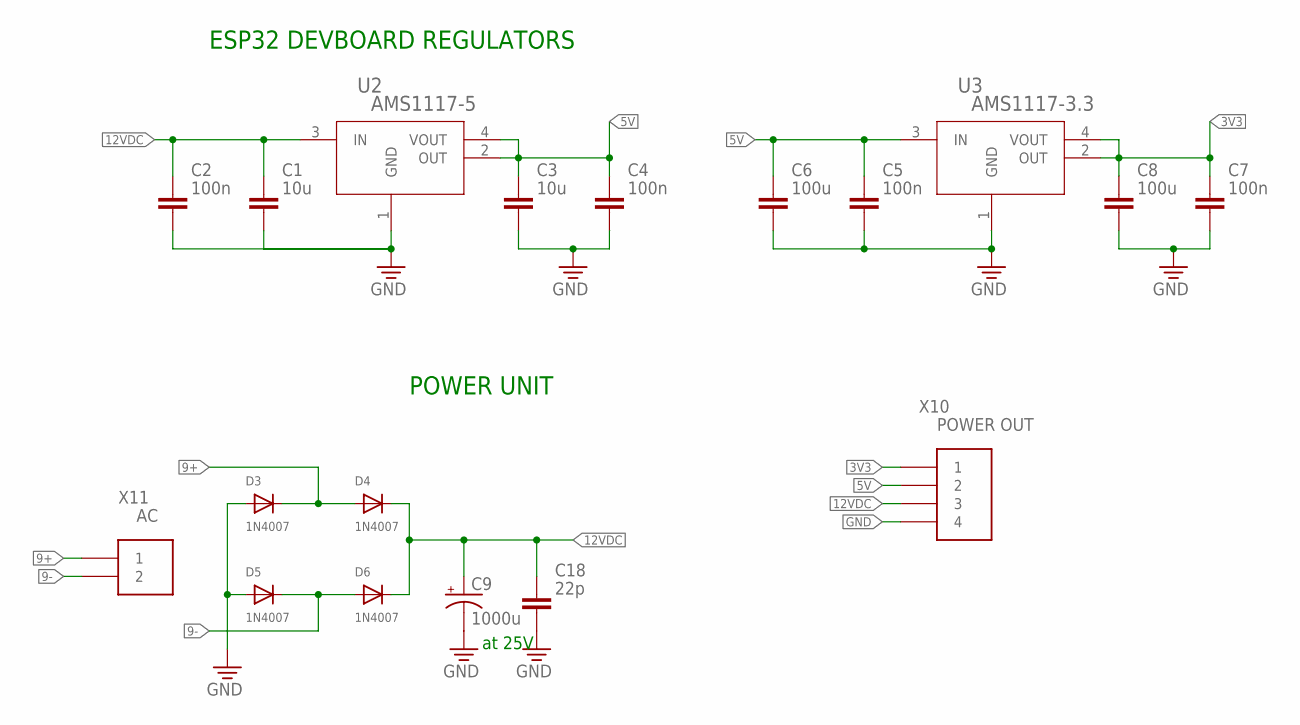
[picture p20: schematic v1.1 Power.sch]

Parts:
C1, C3: 10u; CAPC2012X110
C2, C4, C5, C7: 100n; CAPC2012X110
C6, C8: 100u; CAPC2012X110
C9: 1000u; CAP_10X20IN
C18: 22p; CAPC2012X110
D3, D4, D5, D6: 1N4007; SOD-123FL
U2: AMS1117-5; _AMS-L
U3: AMS1117-3.3; _ADS-L
X10: POWER OUT; JST-XH-04-PACKAGE-LONG-PAD
X11: AC; -LONG-PAD

Connections:
3V3: C7.1, C8.1, U3.2 (OUT), U3.4 (VOUT), X10.1
5V: C3.1, C4.1, C5.1, C6.1, U2.2 (OUT), U2.4 (VOUT), U3.3 (IN), X10.2
9+: D3.C, D4.A, X11.1
9-: D5.C, D6.A, X11.2
12VDC: C1.1, C2.1, C9.1 (+), C18.1, D4.C, D6.C, U2.3 (IN), X10.3
GND: C1.2, C2.2, C3.2, C4.2, C5.2, C6.2, C7.2, C8.2, C9.2 (-), C18.2, D3.A, D5.A, U2.1 (GND), U3.1 (GND), X10.4

Notes on the sheet:
ESP32 DEVBOARD REGULATORS
POWER UNIT
at 25V
