alinicia/SolderSync/v1.1.0/v1.1 Power.brd

## EAGLE design v1.1.0/v1.1 Power.brd (continued)

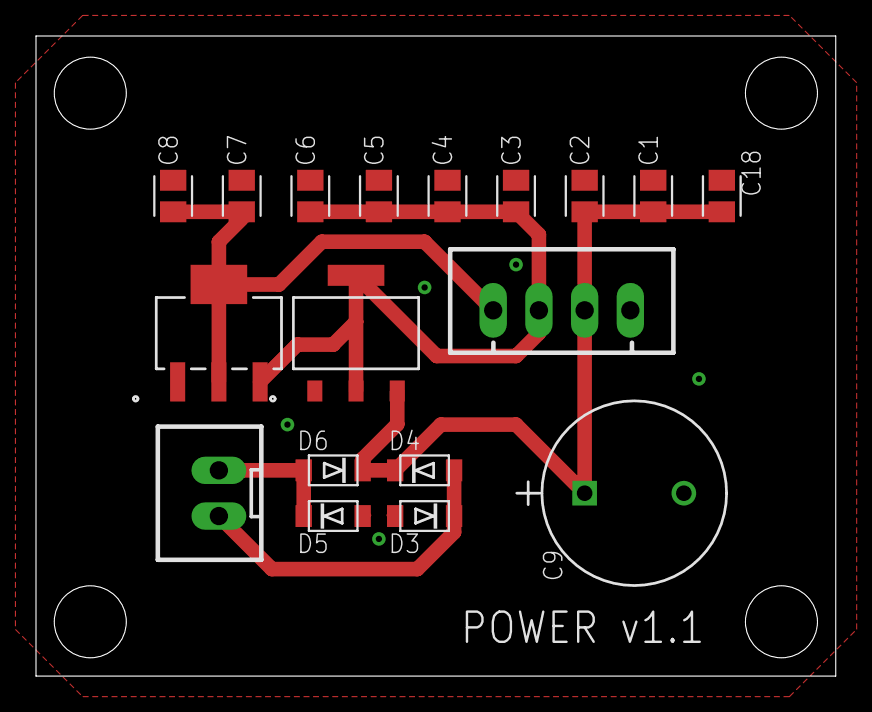
[picture p21: board v1.1 Power.brd from above]

Board: 2 copper layers, 44.4 x 35.6 mm, 18 parts (0 on the bottom side), 6 nets.
