alinicia/SolderSync/v1.0.0/SolderSync_v1_PCB_incomplete.brd

## EAGLE design v1.0.0/SolderSync_v1_PCB_incomplete.brd (2024-11-28, an earlier design)

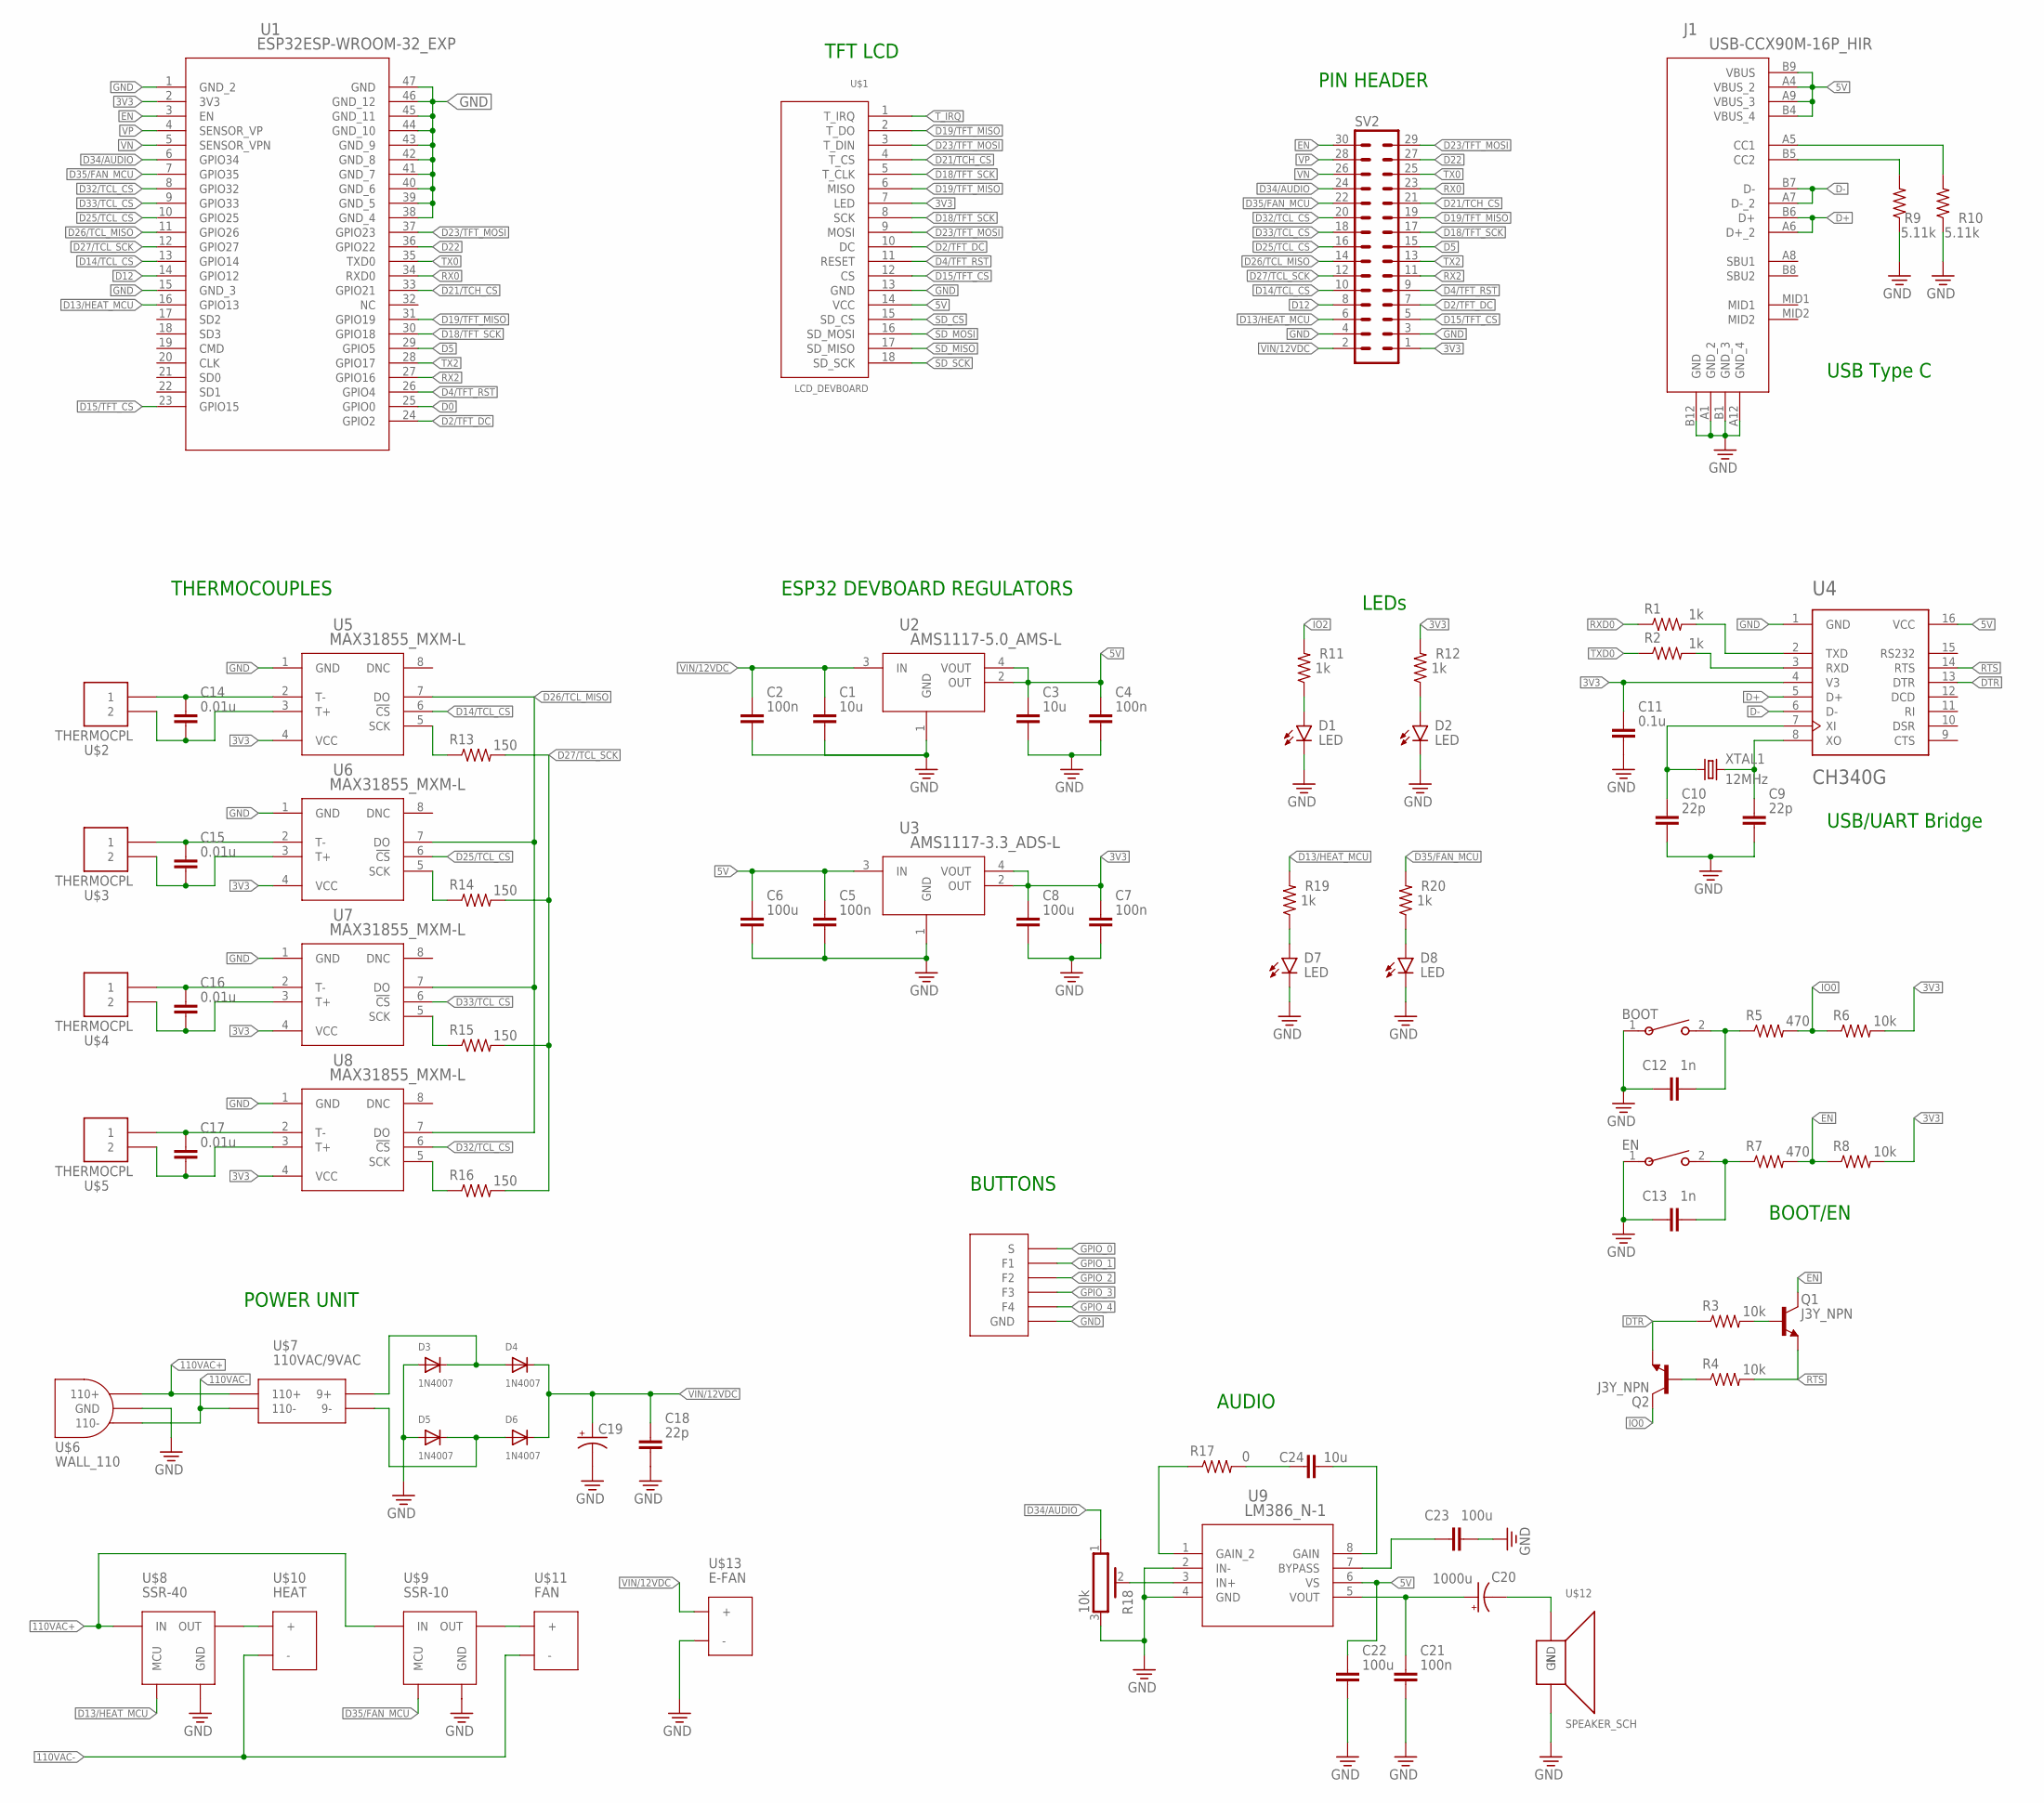
[picture p22: schematic SolderSync_v1_Schematics.sch]

Parts:
BOOT: EVQ22705RSW_EVQ22705R_PAN; SW_EVQ22705R_PAN
C1, C3, C24: 10u; CAPC2012X110
C2, C4, C5, C7, C21: 100n; CAPC2012X110
C6, C8, C22, C23: 100u; CAPC2012X110
C9, C10, C18: 22p; CAPC2012X110
C11: 0.1u; CAPC2012X110
C12, C13: 1n; CAPC2012X110
C14, C15, C16, C17: 0.01u; CAPC2012X110
C19: C-POL-US_ECAP-8.5MM; CAPAE830X1050N
C20: 1000u; CAPAE830X1050N
D1, D2, D7, D8: LED; LEDC2012X110N_FLAT-B
D3, D4, D5, D6: 1N4007; SOD-123FL
EN: EVQ22705RSW_EVQ22705R_PAN; SW_EVQ22705R_PAN
J1: USB-CCX90M-16P_HIR; USB-C
Q1, Q2: J3Y_NPN; SC59
R1, R2, R11, R12, R19, R20: 1k; RESC2012X65
R3, R4, R6, R8: 10k; RESC2012X65
R5, R7: 470; RESC2012X65
R9, R10: 5.11k; RESC2012X65
R13, R14, R15, R16: 150; RESC2012X65
R17: 0; RESC2012X65
R18: 10k; PV36W
SV2: 30-PIN
U1: ESP32ESP-WROOM-32_EXP; ESP32_SCH_PCB
U2: AMS1117-5.0_AMS-L; _AMS-L
U3: AMS1117-3.3_ADS-L; _ADS-L
U4: CH340G; SOIC127P600X180-16N
U5, U6, U7, U8: MAX31855_MXM-L; _MXM-L
U9: LM386_N-1; N08E_TEX
U$1: LCD_DEVBOARD; LCD_SCH
XTAL1: 12MHz; XTALRR488W45L1150T500H350B

Connections:
3V3: C7.1, C8.1, C11.1, R6.2, R8.2, R12.2, SV2.1, U1.2 (3V3), U3.2 (OUT), U3.4 (VOUT), U4.4 (V3), U5.4 (VCC), U6.4 (VCC), U7.4 (VCC), U8.4 (VCC), U$1.7 (LED)
5V: C3.1, C4.1, C5.1, C6.1, C22.1, J1.A4 (VBUS_2), J1.A9 (VBUS_3), J1.B4 (VBUS_4), J1.B9 (VBUS), U2.2 (OUT), U2.4 (VOUT), U3.3 (IN), U4.16 (VCC), U9.6 (VS), U$1.14 (VCC)
CC1: J1.A5 (CC1), R10.2
CC2: J1.B5 (CC2), R9.2
D0: U1.25 (GPIO0)
D2/TFT_DC: SV2.7, U1.24 (GPIO2), U$1.10 (DC)
D4/TFT_RST: SV2.9, U1.26 (GPIO4), U$1.11 (RESET)
D5: SV2.15, U1.29 (GPIO5)
D12: SV2.8, U1.14 (GPIO12)
D13/HEAT_MCU: R19.2, SV2.6, U1.16 (GPIO13)
D14/TCL_CS: SV2.10, U1.13 (GPIO14), U5.6 (!CS)
D15/TFT_CS: SV2.5, U1.23 (GPIO15), U$1.12 (CS)
D18/TFT_SCK: SV2.17, U1.30 (GPIO18), U$1.5 (T_CLK), U$1.8 (SCK)
D19/TFT_MISO: SV2.19, U1.31 (GPIO19), U$1.2 (T_DO), U$1.6 (MISO)
D21/TCH_CS: SV2.21, U1.33 (GPIO21), U$1.4 (T_CS)
D22: SV2.27, U1.36 (GPIO22)
D23/TFT_MOSI: SV2.29, U1.37 (GPIO23), U$1.3 (T_DIN), U$1.9 (MOSI)
D25/TCL_CS: SV2.16, U1.10 (GPIO25), U6.6 (!CS)
D26/TCL_MISO: SV2.14, U1.11 (GPIO26), U5.7 (DO), U6.7 (DO), U7.7 (DO), U8.7 (DO)
D27/TCL_SCK: R13.2, R14.2, R15.2, R16.2, SV2.12, U1.12 (GPIO27)
D32/TCL_CS: SV2.20, U1.8 (GPIO32), U8.6 (!CS)
D33/TCL_CS: SV2.18, U1.9 (GPIO33), U7.6 (!CS)
D34/AUDIO: R18.1, SV2.24, U1.6 (GPIO34)
D35/FAN_MCU: R20.2, SV2.22, U1.7 (GPIO35)
D+: J1.A6 (D+_2), J1.B6 (D+), U4.5 (D+)
D-: J1.A7 (D-_2), J1.B7 (D-), U4.6 (D-)
DTR: Q2.E, R3.1, U4.13 (DTR)
EN: Q1.C, R7.2, R8.1, SV2.30, U1.3 (EN)
GND: BOOT.1, C1.2, C2.2, C3.2, C4.2, C5.2, C6.2, C7.2, C8.2, C9.2, C10.2, C11.2, C12.1, C13.1, C18.2, C19.2 (-), C21.2, C22.2, C23.2, D1.C, D2.C, D3.A, D5.A, D7.C, D8.C, EN.1, J1.A1 (GND_2), J1.A12 (GND_4), J1.B1 (GND_3), J1.B12 (GND), R9.1, R10.1, R18.3, SV2.3, SV2.4, U1.1 (GND_2), U1.15 (GND_3), U1.38 (GND_4), U1.39 (GND_5), U1.40 (GND_6), U1.41 (GND_7), U1.42 (GND_8), U1.43 (GND_9), U1.44 (GND_10), U1.45 (GND_11), U1.46 (GND_12), U1.47 (GND), U2.1 (GND), U3.1 (GND), U4.1 (GND), U5.1 (GND), U6.1 (GND), U7.1 (GND), U8.1 (GND), U9.2 (IN-), U9.4 (GND), U$1.13 (GND)
IO0: Q2.C, R5.2, R6.1
IO2: R11.2
unnamed: D1.A, R11.1
unnamed: Q1.B, R3.2
unnamed: BOOT.2, C12.2, R5.1
unnamed: Q2.B, R4.1
unnamed: C14.2, U5.3 (T+)
unnamed: D2.A, R12.1
unnamed: D3.C, D4.A
unnamed: C13.2, EN.2, R7.1
unnamed: D5.C, D6.A
unnamed: C14.1, U5.2 (T-)
unnamed: C15.2, U6.3 (T+)
unnamed: C20.1 (+), C21.1, U9.5 (VOUT)
unnamed: C15.1, U6.2 (T-)
unnamed: C16.2, U7.3 (T+)
unnamed: C23.1, U9.7 (BYPASS)
unnamed: C16.1, U7.2 (T-)
unnamed: C17.2, U8.3 (T+)
unnamed: C24.1, R17.2
unnamed: C17.1, U8.2 (T-)
unnamed: R17.1, U9.1 (GAIN_2)
unnamed: C24.2, U9.8 (GAIN)
unnamed: R18.2, U9.3 (IN+)
unnamed: D7.A, R19.1
unnamed: D8.A, R20.1
RTS: Q1.E, R4.2, U4.14 (RTS)
RX0: SV2.23, U1.34 (RXD0)
RX2: SV2.11, U1.27 (GPIO16)
RXD: R2.2, U4.3 (RXD)
RXD0: R1.1
SD_CS: U$1.15 (SD_CS)
SD_MISO: U$1.17 (SD_MISO)
SD_MOSI: U$1.16 (SD_MOSI)
SD_SCK: U$1.18 (SD_SCK)
TCL_SCK1: R13.1, U5.5 (SCK)
TCL_SCK2: R14.1, U6.5 (SCK)
TCL_SCK3: R15.1, U7.5 (SCK)
TCL_SCK4: R16.1, U8.5 (SCK)
TX0: SV2.25, U1.35 (TXD0)
TX2: SV2.13, U1.28 (GPIO17)
TXD: R1.2, U4.2 (TXD)
TXD0: R2.1
T_IRQ: U$1.1 (T_IRQ)
VIN/12VDC: C1.1, C2.1, C18.1, C19.1 (+), D4.C, D6.C, SV2.2, U2.3 (IN)
VN: SV2.26, U1.5 (SENSOR_VPN)
VP: SV2.28, U1.4 (SENSOR_VP)
XO: C9.1, C10.1, U4.7 (XI), U4.8 (XO), XTAL1.1, XTAL1.2

Notes on the sheet:
ESP32 DEVBOARD REGULATORS
USB/UART Bridge
USB Type C
BOOT/EN
LEDs
THERMOCOUPLES
POWER UNIT
AUDIO
BUTTONS
TFT LCD
PIN HEADER

Board: 2 copper layers, 69 parts (0 on the bottom side), 68 nets, no tracks yet.
