alinicia/SolderSync/(commit log)

2024-11-28 Rename Schematics_v1/Full Schematics_v1.rar to v1.0.0/Schematics/Full Schematics_v1.rar
2024-11-28 Rename Schematics_v1/PIN HEADER.png to v1.0.0/Schematics/PIN HEADER.png
2024-11-28 Rename Schematics_v1/VOLTAGE REGULATORS.png to v1.0.0/Schematics/VOLTAGE REGULATORS.png
2025-04-17 2.1 update
    [v2.1 Main.brd, v2.1 Main.sch, v2.1 Power.brd, v2.1 Power.sch]
2025-04-17 2.1 add
    [v1 USB_UART.brd, v1 USB_UART.sch, v1.5 USB_UART.brd, v1.5 USB_UART.sch, v2.1 USB_UART.brd, v2.1 USB_UART.sch]
