alinicia/SolderSync/(notices)

Notices in the files:
parts and their libraries:
SD-SolderSync-Library: COPYRIGHT: Copyright (C) 2024 Ultra Librarian. All rights reserved.
SD-SolderSync-Library: COPYRIGHT: Copyright (C) 2025 Ultra Librarian. All rights reserved.
